cedricleonardo/ECE-388-Project/README.md

# ECE-388-Project

DC Programmable Load project for ECE 388
