cedricleonardo/ECE-388-Project/renders/Programmable DC Load.pdf

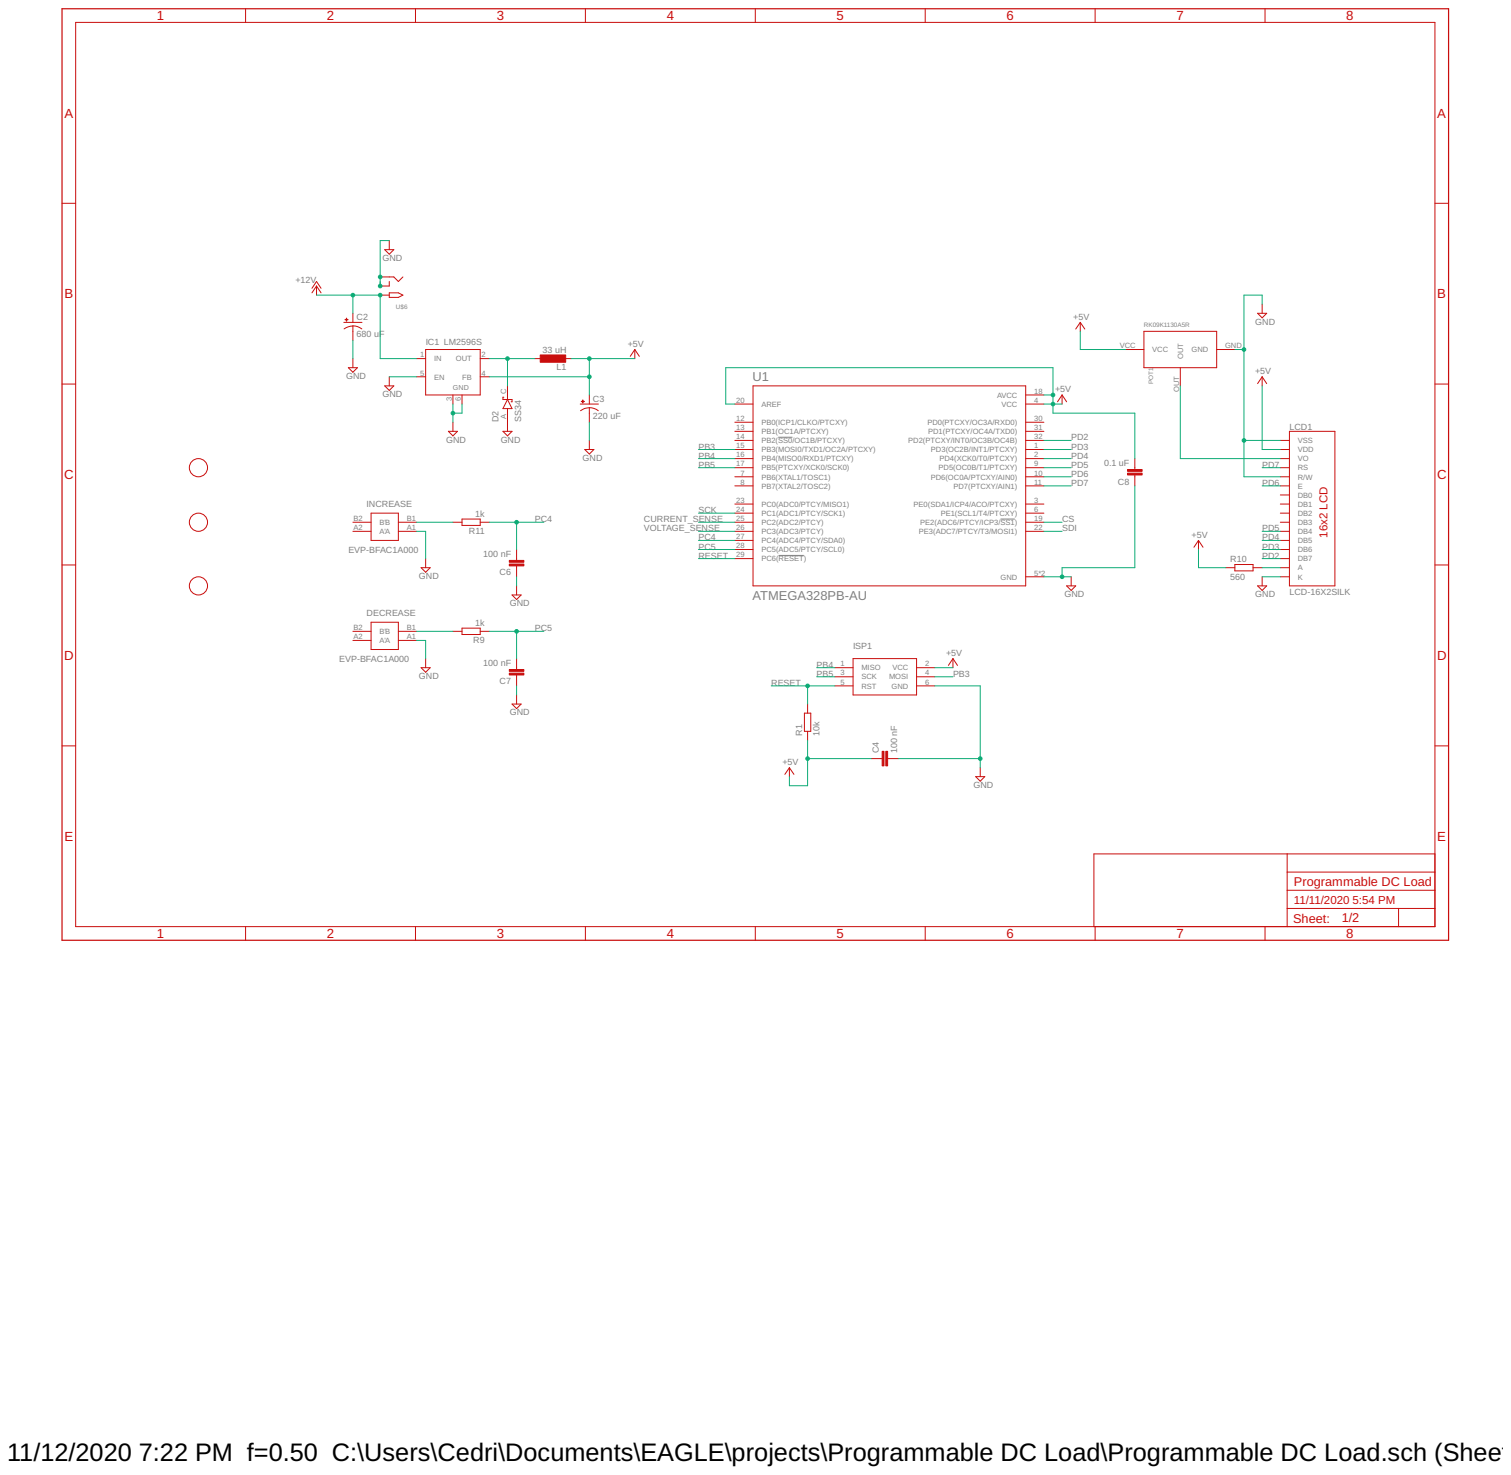
[picture p1: page 1]

11/12/2020 7:22 PM f=0.50 C:\Users\Cedri\Documents\EAGLE\projects\Programmable DC Load\Programmable DC Load.sch (Sheet: 1/2)

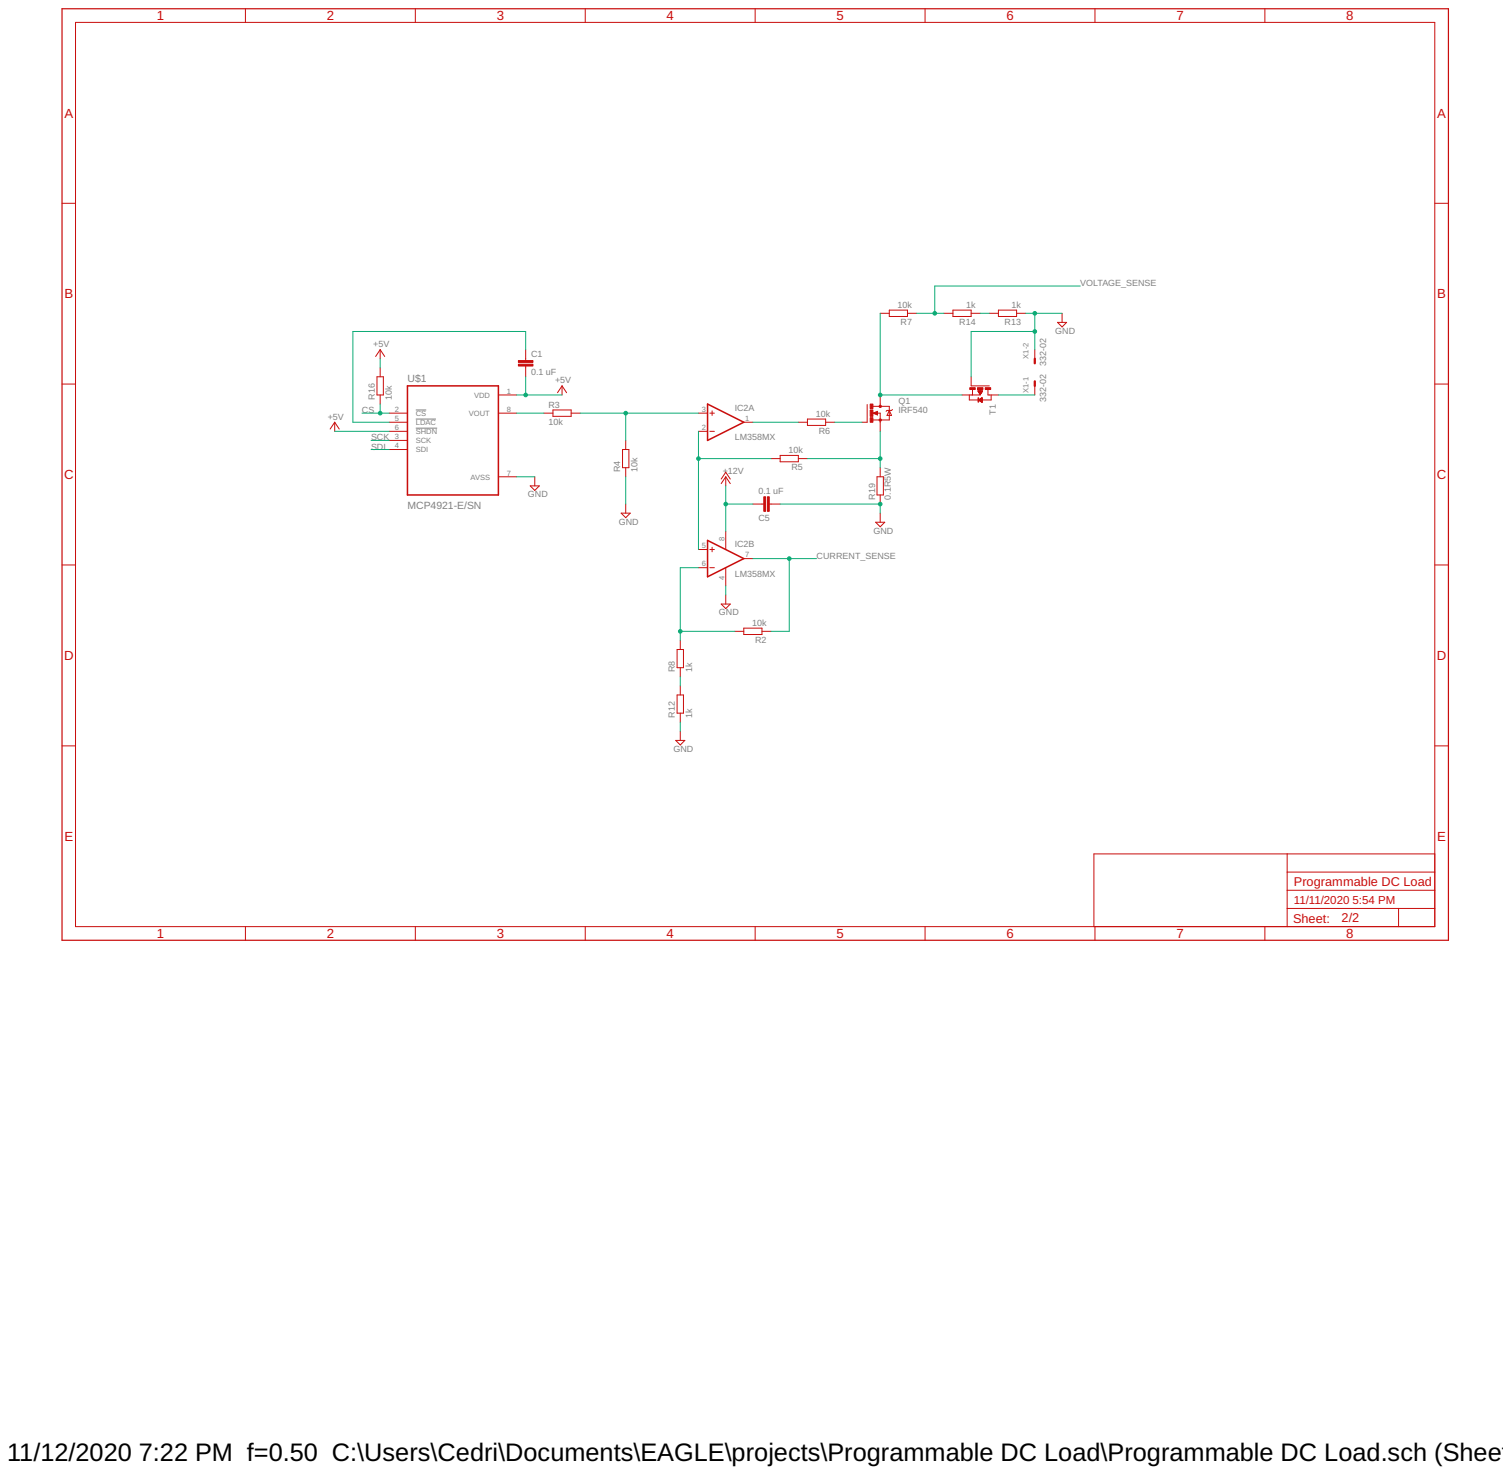
[picture p2: page 2]

11/12/2020 7:22 PM f=0.50 C:\Users\Cedri\Documents\EAGLE\projects\Programmable DC Load\Programmable DC Load.sch (Sheet: 2/2)
