cedricleonardo/ECE-388-Project/Programmable DC Load.brd

## EAGLE design Programmable DC Load.brd (2020-11-12)

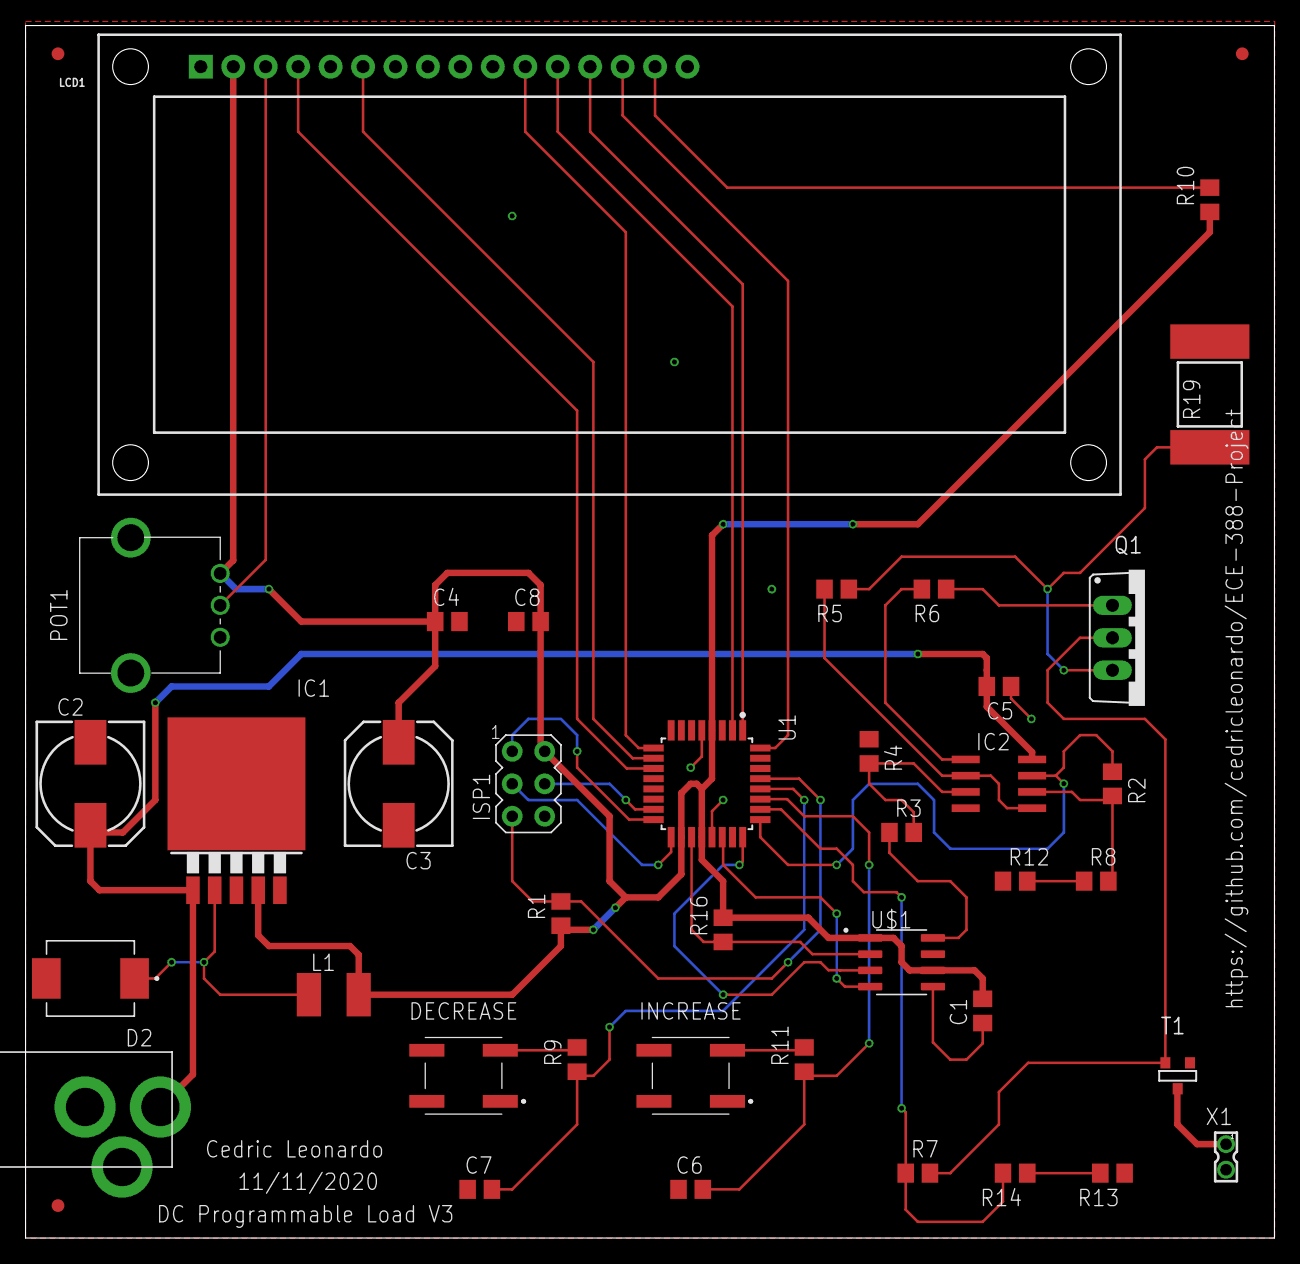
[picture p3: board Programmable DC Load.brd from above]

Board: 2 copper layers, 97.8 x 94.9 mm, 42 parts (0 on the bottom side), 37 nets.

Parts:
C1, C5, C8: 0.1 uF; C0805
C2: 680 uF; 140CLH-0810
C3: 220 uF; 140CLH-0810
C4, C6, C7: 100 nF; C0805
D2: SS34; DIOM7959X265N
DECREASE: EVP-BFAC1A000; EVPBFAC1A000
IC1: LM2596S; TO263-5
IC2: LM358MX; SO08
INCREASE: EVP-BFAC1A000; EVPBFAC1A000
ISP1: AVRISP-6; AVRISP
L1: 33 uH; L1812
LCD1: LCD-16X2SILK; LCD-16X2
POT1: RK09K1130A5R
Q1: IRF540; TO220BV
R1, R2, R3, R4, R5, R6, R7, R16: 10k; R0805
R8, R9, R11, R12, R13, R14: 1k; R0805
R10: 560; R0805
R19: 0.1R5W; BVS
T1: SOT-23
U1: ATMEGA328PB-AU; QFP80P900X900X120-32N
U$1: MCP4921-E/SN; SOIC127P600X175-8N
U$2, U$3, U$4: FIDUCIAL; FIDUCIAL_1MM
U$6: 2.1MMJACKTHM; PJ-102A
X1: 332-02

Connections:
+5V: C1.2, C3.+, C4.1, C8.2, IC1.4, ISP1.2, L1.2, LCD1.2, POT1.VCC, R1.1, R10.1, R16.2, U1.4, U1.18, U1.20, U$1.1, U$1.6
+12V: C2.+, C5.2, IC1.1, IC2.8, U$6.TIP
CS: R16.1, U1.19, U$1.2
CURRENT_SENSE: IC2.7, R2.1, U1.25
GND: C2.-, C3.-, C4.2, C5.1, C6.1, C7.1, C8.1, D2.A, DECREASE.A1, IC1.3, IC1.5, IC1.6, IC2.4, INCREASE.A1, ISP1.6, LCD1.1, LCD1.5, LCD1.16, POT1.GND, R4.1, R12.1, R13.1, R19.2, T1.3, U1.5, U1.21, U$1.7, U$6.RING, U$6.RING_SW, X1.2
unnamed: R8.1, R12.2
unnamed: R13.2, R14.1
unnamed: LCD1.15, R10.2
unnamed: D2.C, IC1.2, L1.1
unnamed: T1.1, X1.1
unnamed: DECREASE.B1, R9.2
unnamed: INCREASE.B1, R11.2
unnamed: IC2.3, R3.2, R4.2
unnamed: LCD1.3, POT1.OUT
unnamed: IC2.1, R6.2
unnamed: Q1.G, R6.1
unnamed: IC2.2, IC2.5, R5.2
unnamed: Q1.S, R5.1, R19.1
unnamed: Q1.D, R7.2, T1.2
unnamed: IC2.6, R2.2, R8.2
unnamed: R3.1, U$1.8
unnamed: C1.1, U$1.5
PB3: ISP1.4, U1.15
PB4: ISP1.1, U1.16
PB5: ISP1.3, U1.17
PC4: C6.2, R11.1, U1.27
PC5: C7.2, R9.1, U1.28
PD2: LCD1.14, U1.32
PD3: LCD1.13, U1.1
PD4: LCD1.12, U1.2
PD5: LCD1.11, U1.9
PD6: LCD1.6, U1.10
PD7: LCD1.4, U1.11
RESET: ISP1.5, R1.2, U1.29
SCK: U1.24, U$1.3
SDI: U1.22, U$1.4
VOLTAGE_SENSE: R7.1, R14.2, U1.26
