cedricleonardo/ECE-388-Project/(threads)

Thread 1 (2020-11-07):

Schematic Submission

timChase98, 2020-11-07:
- [ ] Review the submission guidelines [HERE](https://github.com/timChase98/388Example)
- [ ] All project files should be version controlled
- [ ] C3 should point to down to gnd not up
- [ ] Use a 2 pin connector for the load connection not a DC jack
- [ ] How does your current sense measurement work?

Please address these issues and push your changes. Then create a new release, increment the tag and close this issue. I will review the changes and mark this as complete or reopen the issue with additional feedback.

cedricleonardo, 2020-11-07:
For the current sense measurement I was thinking of using analog read and ohms law to get the current going through the op amp. I would then display this value, the voltage, and load on my LCD.

timChase98, 2020-11-10:
- [ ] Change R1 to 10k
- [ ] Change R11 and R9 to 1k
- [ ] Add a pull up resistor to the CS pin on U$1
- [ ] Look into protection for reverse voltage on test connector

timChase98, 2020-11-11:
- [ ] Add your eagle files to the repo
- [ ] A negative voltage on the test connector would still kill your ADC.  Move the protection fet onto the negative line

timChase98, 2020-11-11:
I'll accept this.  You can move onto layout.  Clean up some of your nets and I'll give it a pass

cedricleonardo, 2020-11-11:
I cleaned up some of the nets, especially around the op amps.

timChase98, 2020-11-11:
Rotate the LCD so all the text is the right way and you are good to go.

cedricleonardo, 2020-11-11:
I rotated the LCD

timChase98, 2020-11-11:
Looks good.  I'll give it a pass

Closed 2020-11-11.

Thread 2 (2020-11-08):

Board Submission

timChase98, 2020-11-08:
- [ ] Review the submission guidelines [HERE](https://github.com/timChase98/388Example)
- [ ] All project files should be version controlled
- [ ] Boards will not be graded unless both Eagle files and correctly generated Gerber files are present
- [ ] All traces should hit the center of pads
- [ ] Power traces should have a minimum width of 12 mil or run through a plane
- [ ] Silkscreen labels must include
  - [ ] Your Name
  - [ ] Project Name
  - [ ] Date
  - [ ] Version/Rev
  - [ ] Github Link
- [ ] Your project would fit on a much smaller board
- [ ] Placement of fiducials should be
  - [ ] FID1 lower left
  - [ ] FID2 upper left
  - [ ] FID3 lower right
- [ ] Traces should never intersect at an acute angle
- [ ] Shorter traces are better
- [ ] Increase the trace width for thermal relief for the power supply

These are initial comments meant to guide you though the layout process.  I will not look at your board again until your schematic passes review.  This is to reduce the workload on you by limiting the number of times you need to relayout your board due to schematic errors.

Please address these issues and push your changes. Then create a new release, increment the tag and close this issue. I will review the changes and mark this as complete or reopen the issue with additional feedback.

timChase98, 2020-11-11:
- [ ] check datasheet for DC jack for correct footprint
- [ ] check stock sheet for correct footprints for ICs
- [ ] Run a DRC and ERC
- [ ] Q1 is too close to the edge of the board.
- [ ] You have silkscreen overlapping pads and other silkscreen

cedricleonardo, 2020-11-12:
@timChase98 was my board approved, I just wanted to make sure I meet the deadline

timChase98, 2020-11-12:
Font size is too small.  Run normalize text ulp and set to 8 mil stroke width

cedricleonardo, 2020-11-12:
Fixed font size to 8 mil stroke

timChase98, 2020-11-12:
Your board will be sent to fab

Closed 2020-11-12.
