cedricleonardo/ECE-388-Project/(commit log)

2020-11-06 Rename renders/Gerber/Programmable DC Load.GBL to renders/Gerb/Programmable DC Load.GBL
    [Programmable DC Load.GBL]
2020-11-06 Rename renders/Gerber/Programmable DC Load.GBO to renders/Gerb/Programmable DC Load.GBO
    [Programmable DC Load.GBO]
2020-11-06 Rename renders/Gerber/Programmable DC Load.GBP to renders/Gerb/Programmable DC Load.GBP
    [Programmable DC Load.GBP]
2020-11-06 Rename renders/Gerber/Programmable DC Load.GBS to renders/Gerb/Programmable DC Load.GBS
    [Programmable DC Load.GBS]
2020-11-06 Rename renders/Gerber/Programmable DC Load.GKO to renders/Gerb/Programmable DC Load.GKO
    [Programmable DC Load.GKO]
2020-11-06 Rename renders/Gerber/Programmable DC Load.GTL to renders/Gerb/Programmable DC Load.GTL
    [Programmable DC Load.GTL]
2020-11-06 Rename renders/Gerber/Programmable DC Load.GTO to renders/Gerb/Programmable DC Load.GTO
    [Programmable DC Load.GTO]
2020-11-06 Rename renders/Gerber/Programmable DC Load.GTP to renders/Gerb/Programmable DC Load.GTP
    [Programmable DC Load.GTP]
2020-11-06 Rename renders/Gerber/Programmable DC Load.GTS to renders/Gerb/Programmable DC Load.GTS
    [Programmable DC Load.GTS]
2020-11-06 Rename renders/Gerber/Programmable DC Load.TXT to renders/Gerb/Programmable DC Load.TXT
